cskarai/ledstriporgan/docs/images/youtube-video.png

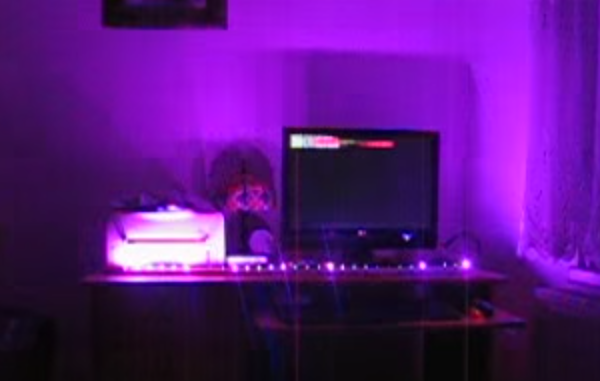
docs/images/youtube-video.png
