cskarai/ledstriporgan/docs/svgs/beat_detect.png

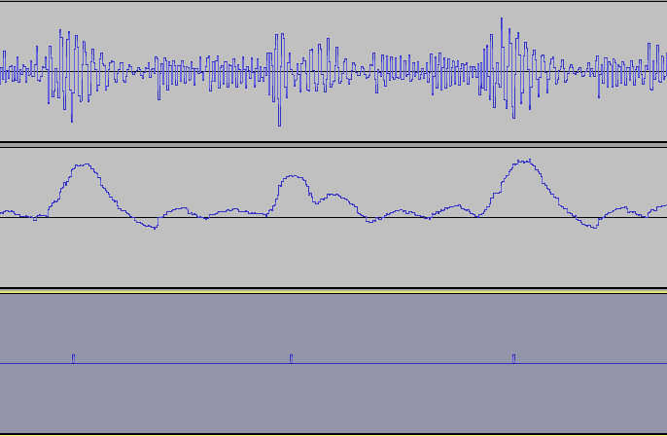
docs/svgs/beat_detect.png
