cskarai/ledstriporgan/docs/svgs/beat_state.png

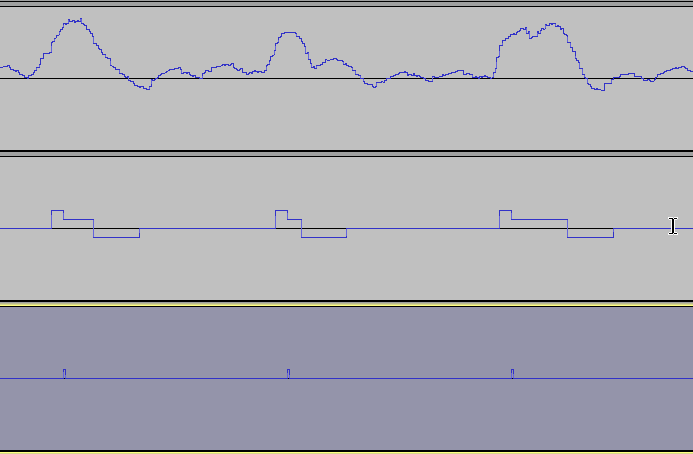
docs/svgs/beat_state.png
