cskarai/ledstriporgan/(list of files, drawings)

Other design files:
docs/designspark/STM32LedStripOrgan.pcb
