cskarai/ledstriporgan/include/randomseed.h

/*
 * randomseed.h
 */

#ifndef RANDOMSEED_H_
#define RANDOMSEED_H_

#ifdef __cplusplus
extern "C"
{
#endif

uint32_t create_random_seed(void);

#ifdef __cplusplus
}
#endif

#endif /* RANDOMSEED_H_ */
