cskarai/ledstriporgan/(commit log)

2017-11-03 STM32 LED Strip Organ
2017-11-06 Schema and PCB
    [STM32LedStripOrgan.pcb, STM32LedStripOrgan.sch]
2017-11-09 Filter bass for 170 samples
2017-11-10 Low pass filter
2017-11-12 Hungarian translation: LED controlling
2017-11-12 Hungarian: circuit documentation
2017-11-12 Updated circuit diagram
    [STM32LedStripOrgan.pcb, STM32LedStripOrgan.sch]
